leaflabs/lotus-cmvbreakout/Documents/cmv12000_breakout.pdf

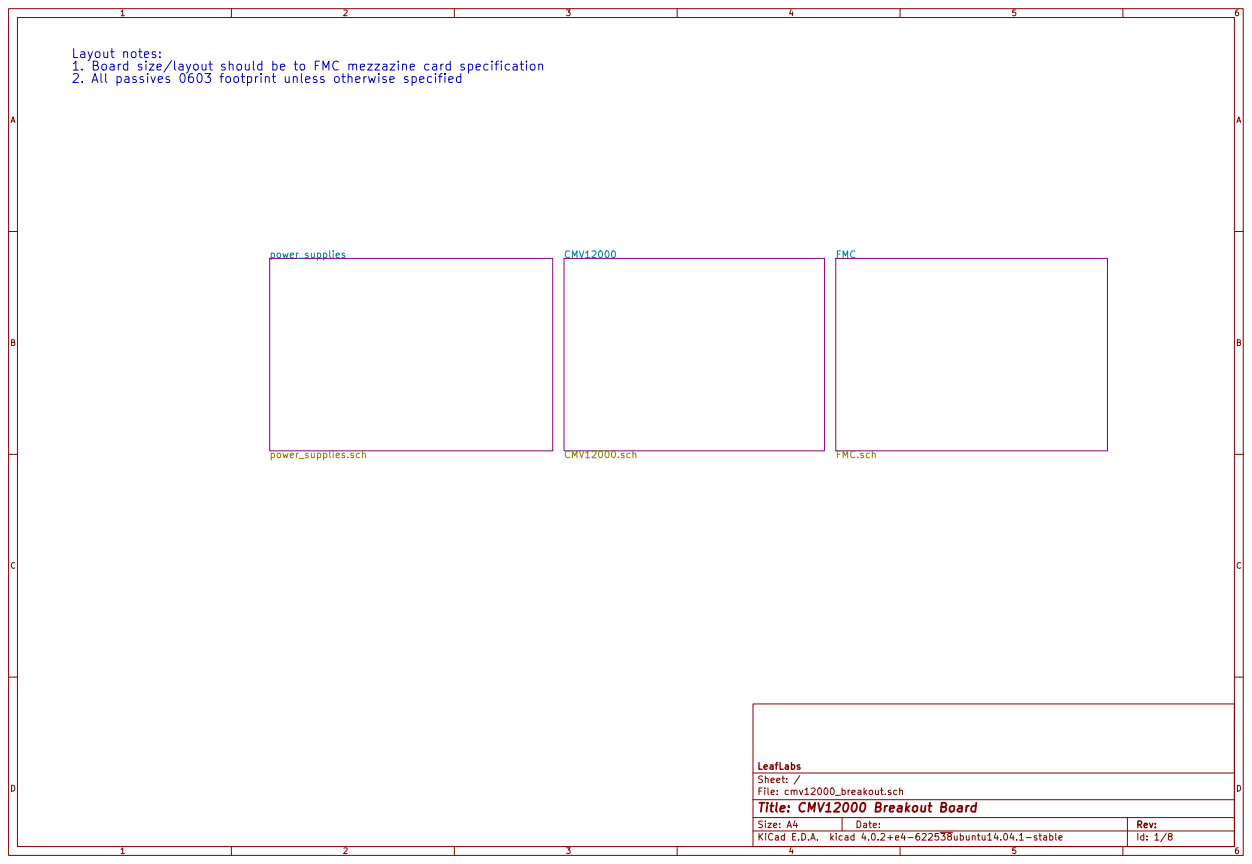
[picture p1: page 1]

Layout notes:
1. Board size/layout should be to FMC mezzazine card specification
2. All passives 0603 footprint unless otherwise specified

File: cmv12000_breakout.sch Sheet: / LeafLabs

Id: 1/8 Title: CMV12000 Breakout Board

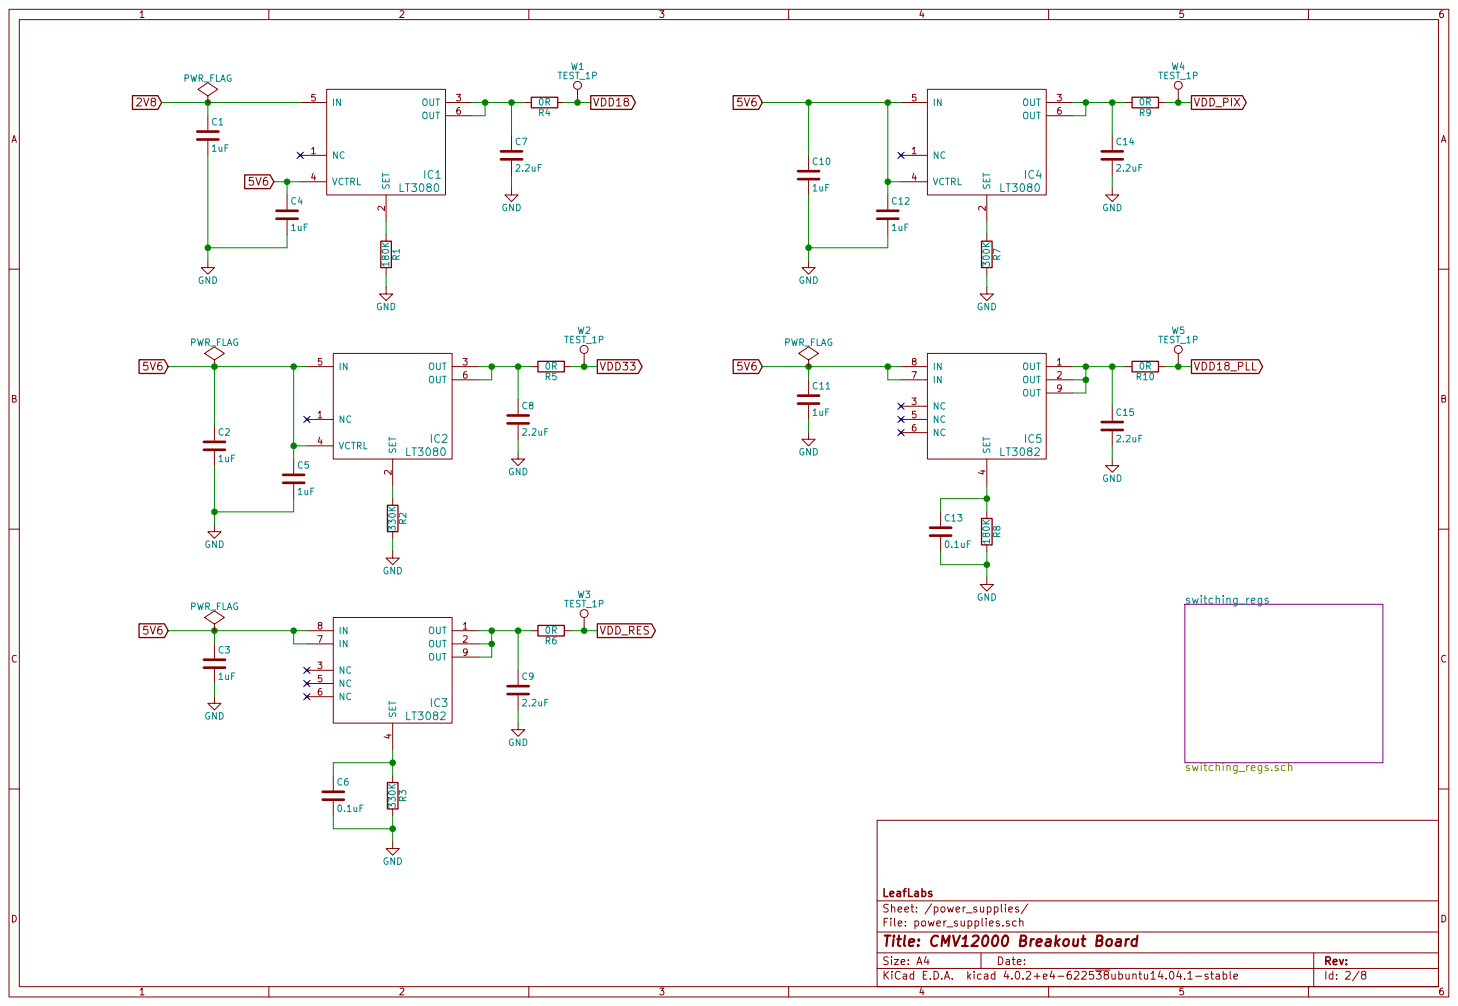
[picture p2: page 2]

File: power_supplies.sch
Id: 2/8 Title: CMV12000 Breakout Board

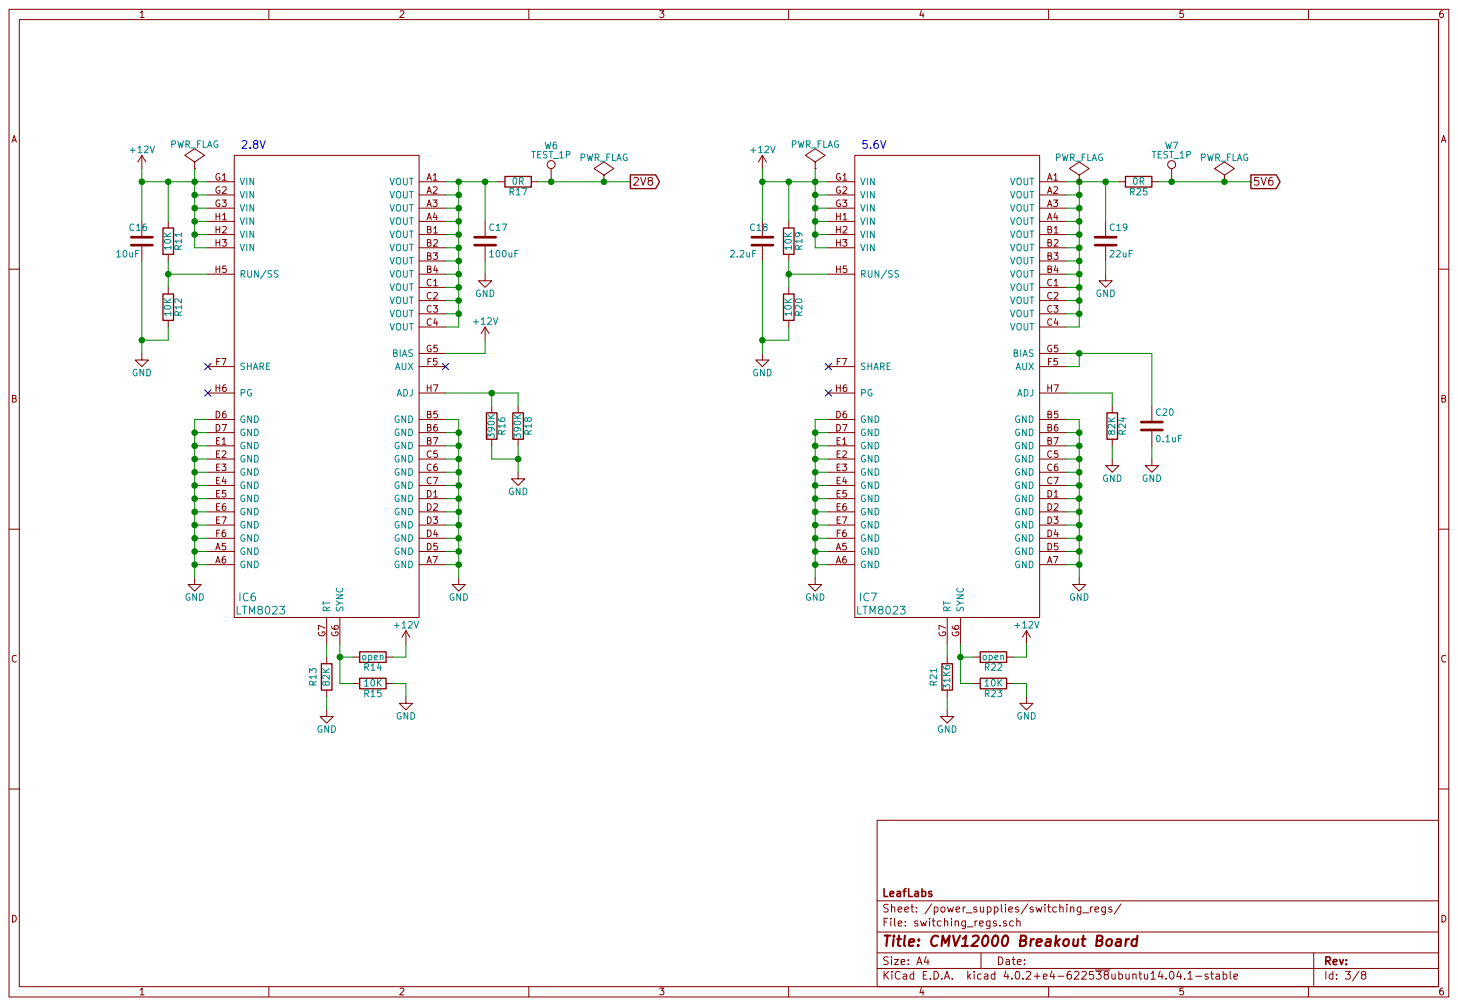
[picture p3: page 3]

File: switching_regs.sch
Id: 3/8 Title: CMV12000 Breakout Board

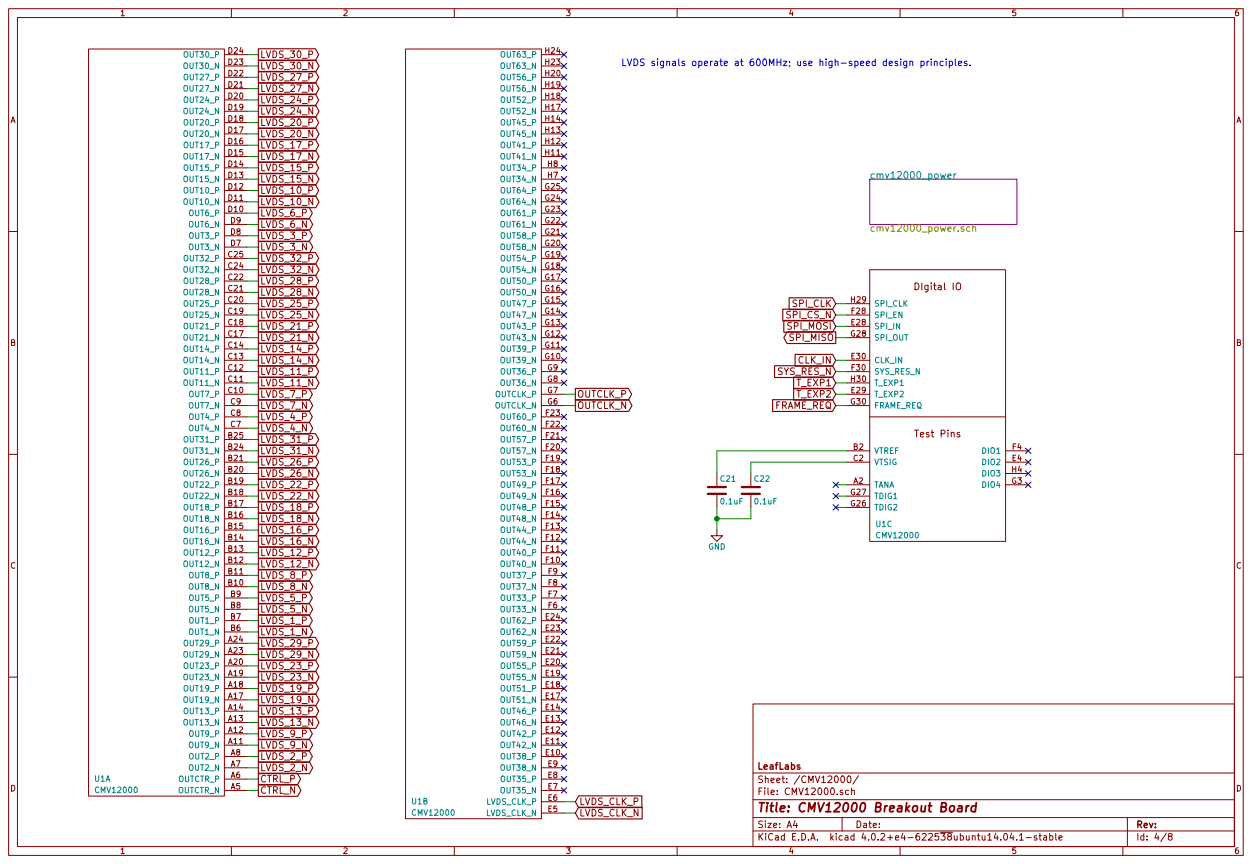
[picture p4: page 4]

LVDS signals operate at 600MHz; use high-speed design principles.

File: CMV12000.sch Sheet: /CMV12000/ LeafLabs

Id: 4/8 Title: CMV12000 Breakout Board

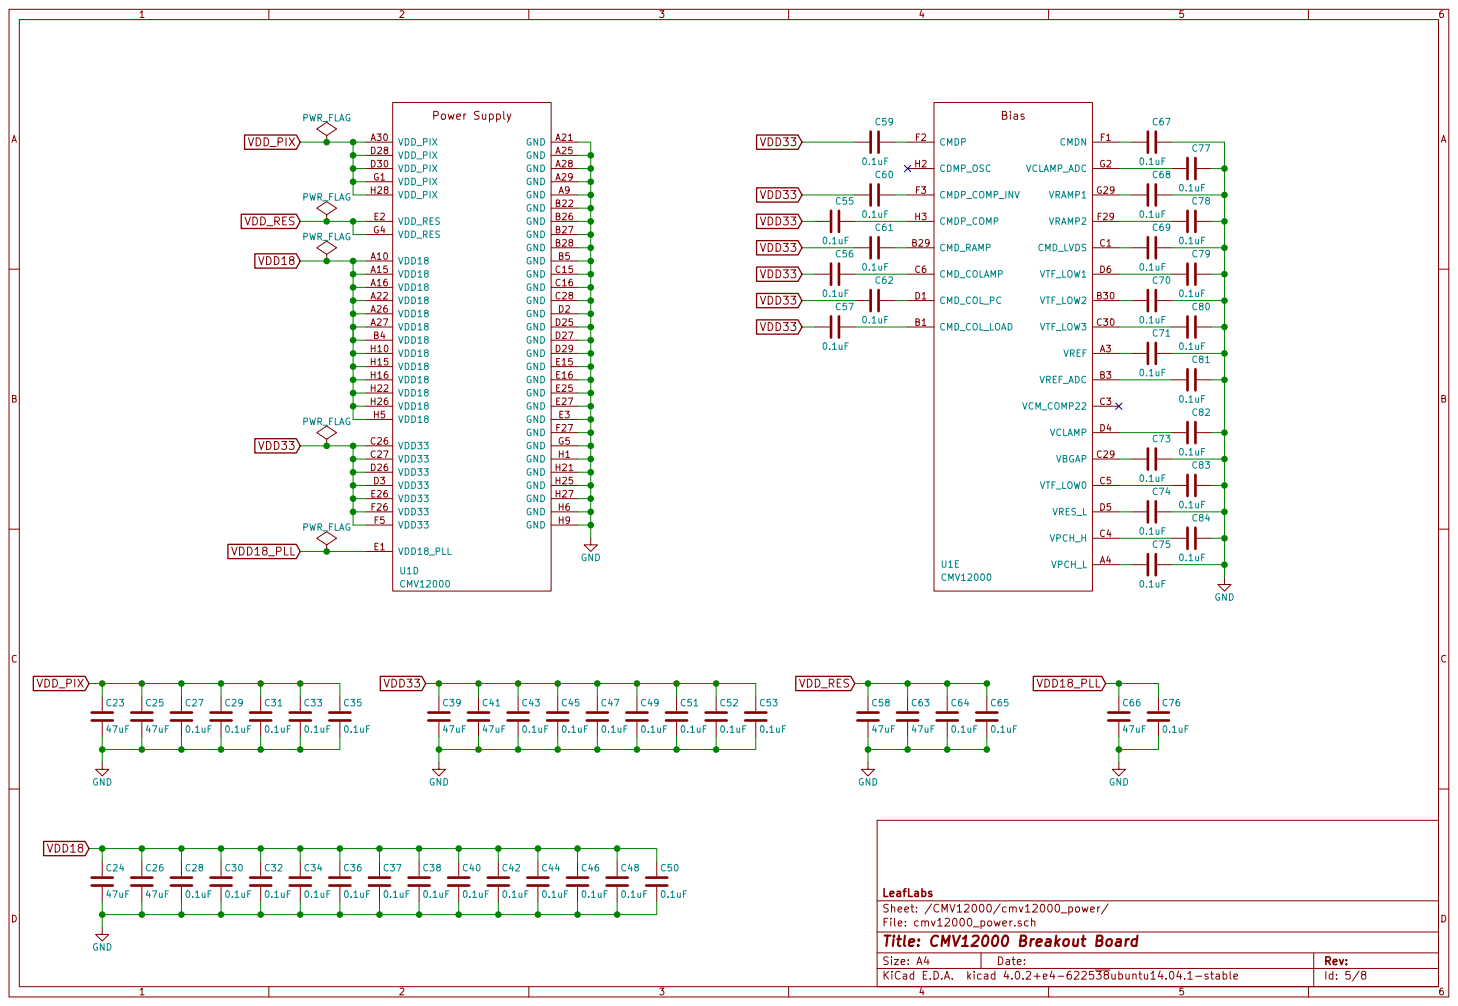
[picture p5: page 5]

File: cmv12000_power.sch
Id: 5/8 Title: CMV12000 Breakout Board

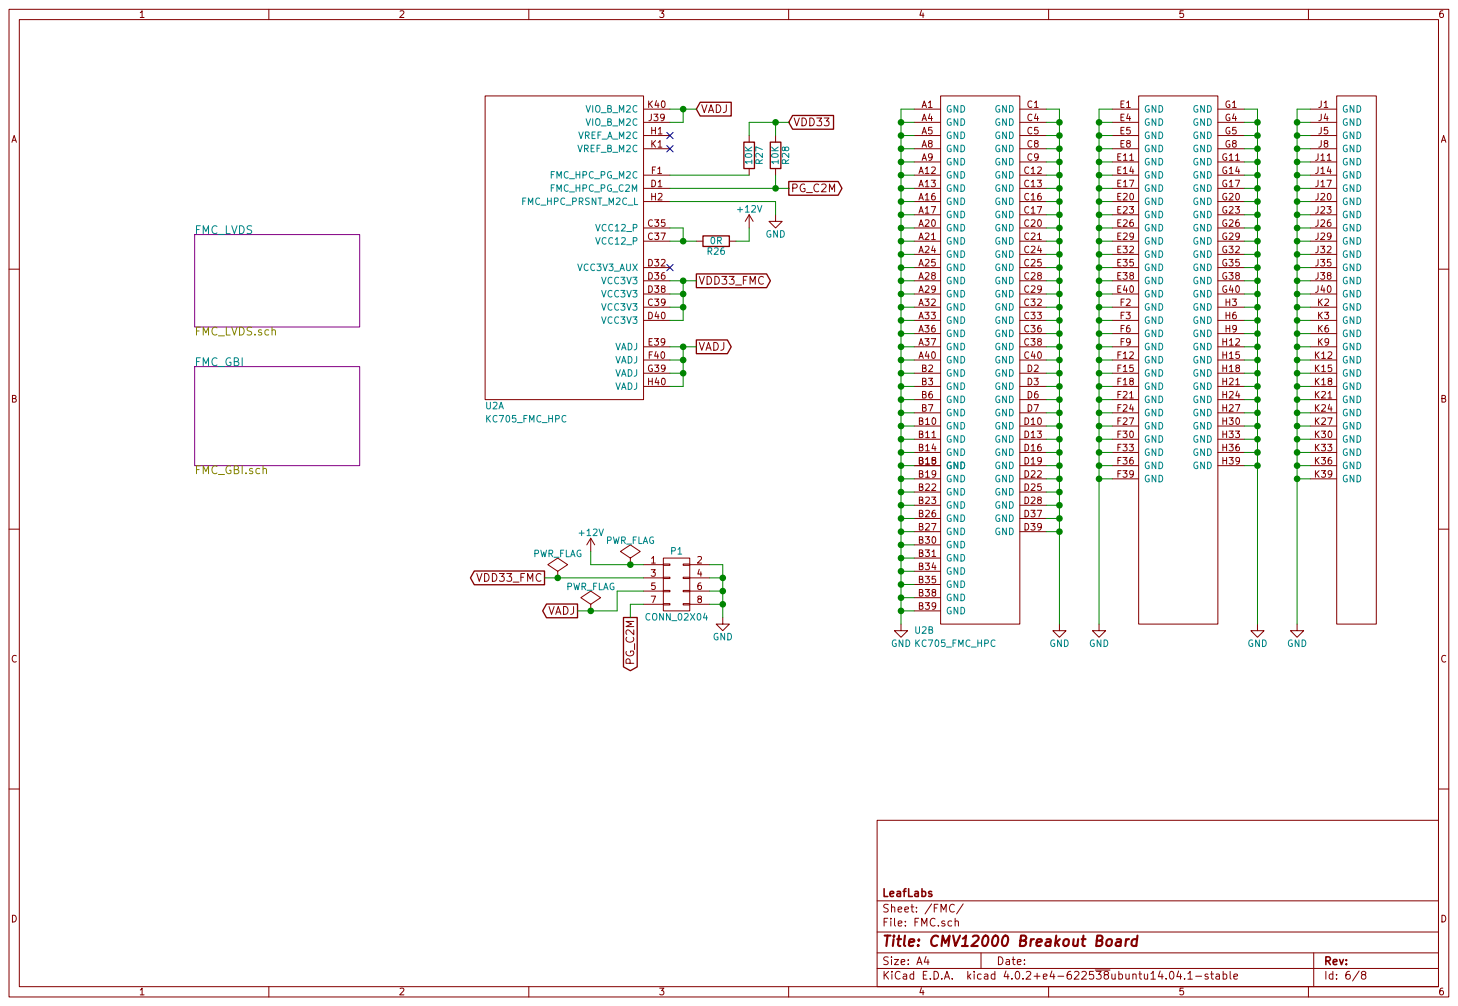
[picture p6: page 6]

File: FMC.sch Sheet: /FMC/ LeafLabs

Id: 6/8 Title: CMV12000 Breakout Board

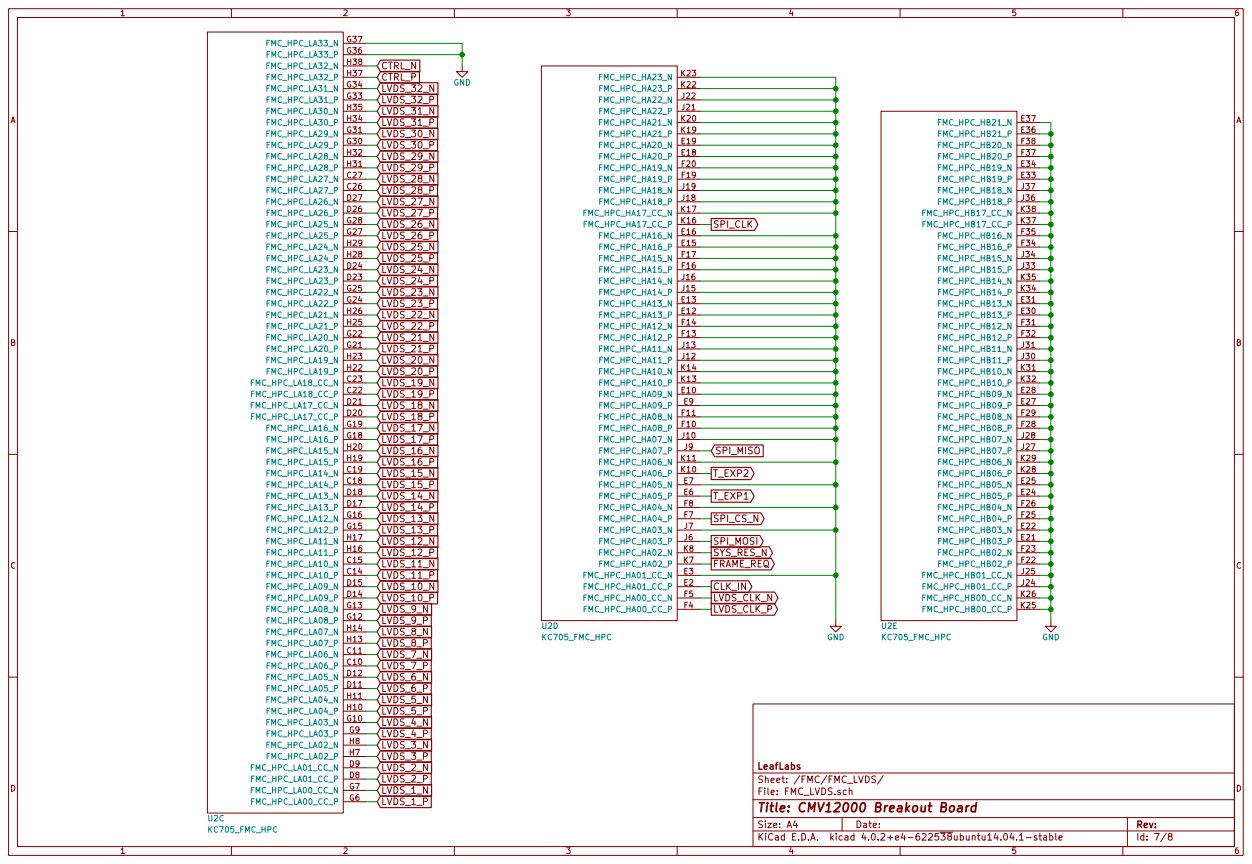
[picture p7: page 7]

SPI_CS_N

SYS_RES_N

File: FMC_LVDS.sch
Id: 7/8 Title: CMV12000 Breakout Board

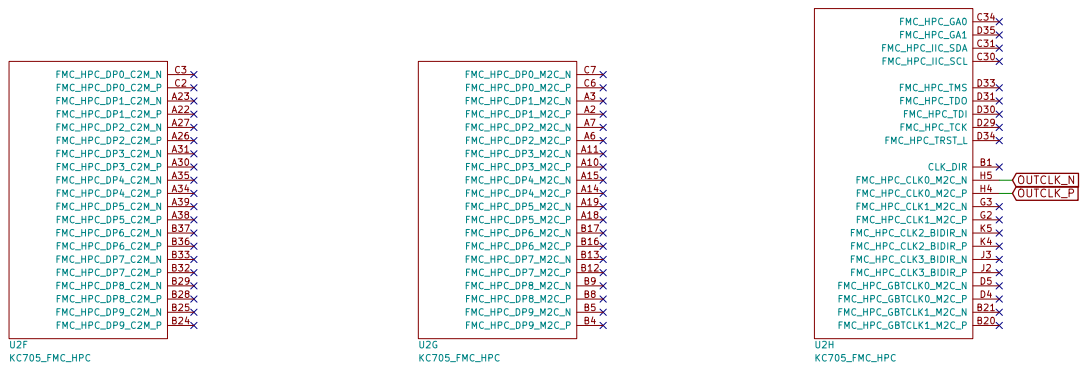
[picture p8: page 8]

File: FMC_GBI.sch
Id: 8/8 Title: CMV12000 Breakout Board
