leaflabs/lotus-cmvbreakout/(commit log)

2016-07-18 Initial commit.
    CMV12000 power banks; other empty schematic sheets.
    [CMV12000.sch, FMC.sch, cmv12000_breakout.kicad_pcb, cmv12000_breakout.sch, cmv12000_power.sch, power_supplies.sch]
2016-07-19 Fixed bypass cap value in CMV12000 power bank schematic.
    [cmv12000_power.sch]
2016-07-19 Added DAC Set Supplies schematic.
    [DAC_set_supplies.sch, power_supplies.sch]
2016-07-19 Added Supply Monitor schematic.
    [power_supplies.sch, supply_monitor.sch]
2016-07-19 Added schematic for 5.6V and 2.8V switching regulators.
    [power_supplies.sch, switching_regs.sch]
2016-07-21 Added subsheets to switching regs.
    [switching_regs.sch]
2016-07-21 Added Supply LP schematic.
    [supply_LP.sch]
2016-07-21 Added Supply MP schematic.
    [supply_MP.sch]
2016-07-21 Added Supply HP (VDD18) schematic.
    [supply_VDD18.sch]
2016-07-22 Various power supplies partially hooked up at top level.
    To control/monitor lines etc.
    [power_supplies.sch]
2016-07-24 Added partial set of LVDS lines to FMC schematic.
    [FMC.sch]
2016-07-24 Rearranged FMC schematics; added another subset of pins.
    [FMC_1.sch, FMC_2.sch]
2016-07-24 Added LVDS signals to CMV12000 page.
    [CMV12000.sch]
2016-07-24 Added control signals to CMV12000 page.
    [CMV12000.sch]
2016-07-24 More top level power supplies hookups.
    [power_supplies.sch]
2016-07-24 Cosmetic/naming changes.
    Automatic sheet renumberings, moving some components around, etc.
    [CMV12000.sch, DAC_set_supplies.sch, FMC.sch, FMC_1.sch, FMC_2.sch, cmv12000_breakout.sch, cmv12000_power.sch, supply_LP.sch]
2016-07-24 Added title/company name.
    [CMV12000.sch, DAC_set_supplies.sch, FMC.sch, FMC_1.sch, FMC_2.sch, cmv12000_breakout.sch, cmv12000_power.sch, power_supplies.sch]
2016-07-25 Added ground bank to FMC schematic.
    [FMC.sch, FMC_1.sch, FMC_2.sch]
2016-07-27 Checkpoint before reworking FMC HPC component.
    [CMV12000.sch, DAC_set_supplies.sch, FMC.sch, FMC_1.sch, FMC_2.sch, cmv12000_breakout.sch, cmv12000_power.sch, power_supplies.sch]
2016-07-27 Rearranging FMC schematic pages.
    [FMC.sch, FMC_LVDS.sch]
2016-07-27 Rearranging/renaming FMC files.
    [FMC_1.sch, FMC_2.sch, FMC_GBI.sch]
2016-07-27 Added relevant FMC units to gigabit interface schematic.
    [FMC_GBI.sch]
2016-07-28 Testpin fixup on CMV12000.
    [CMV12000.sch]
2016-07-30 Simplified power supply circuitry; removed extraneous files.
    Pulled out monitor ADC and supply set DAC; all power supplies are
    now just hard-wired to their various voltage levels.
    [CMV12000.sch, DAC_set_supplies.sch, FMC.sch, FMC_GBI.sch, FMC_LVDS.sch, cmv12000_breakout.sch, cmv12000_power.sch, power_supplies.sch]
2016-08-01 Added power connections to FMC schematic page.
    [FMC.sch]
2016-08-01 Added 0R resistors/test points to power circuitry.
    [power_supplies.sch, switching_regs.sch]
2016-08-01 Annotated components.
    [CMV12000.sch, FMC.sch, FMC_GBI.sch, FMC_LVDS.sch, cmv12000_breakout.sch, cmv12000_power.sch, power_supplies.sch, switching_regs.sch]
2016-08-01 Added no-connects on unused FMC lines.
    [FMC_GBI.sch]
2016-08-01 Minor modifications/bug chasing to pass ERC.
    [CMV12000.sch, FMC.sch, FMC_LVDS.sch, cmv12000_power.sch, power_supplies.sch, switching_regs.sch]
2016-08-01 ERC error cleanup on switching regs and power supplies pages.
    [power_supplies.sch, switching_regs.sch]
2016-08-01 Fixed LVDS pin directionality.
    [CMV12000.sch, FMC.sch, FMC_GBI.sch, FMC_LVDS.sch, cmv12000_breakout.sch, cmv12000_power.sch, power_supplies.sch, switching_regs.sch]
2016-08-02 Annotations; removing unused signals; general cleanup.
    [CMV12000.sch, FMC.sch, FMC_GBI.sch, FMC_LVDS.sch, cmv12000_power.sch, power_supplies.sch, switching_regs.sch]
2016-08-04 added some footprint annotations to power supplies sheet
    [power_supplies.sch]
2016-08-05 started defining footprints and making nonstandard footprints
    [CMV12000.sch, FMC.sch, FMC_GBI.sch, FMC_LVDS.sch, cmv12000_breakout.sch, cmv12000_power.sch, power_supplies.sch, switching_regs.sch]
2016-08-07 simplifying switching regulators
    [CMV12000.sch, FMC.sch, FMC_GBI.sch, FMC_LVDS.sch, cmv12000_breakout.sch, cmv12000_power.sch, power_supplies.sch, switching_regs.sch]
2016-08-08 finished defining footprints
    [CMV12000.sch, FMC.sch, FMC_LVDS.sch, cmv12000_power.sch, power_supplies.sch, switching_regs.sch]
2016-09-06 resolved more footprints and added finishing touches/gerbers
    [CMV12000.sch, FMC.sch, FMC_GBI.sch, FMC_LVDS.sch, cmv12000_breakout.sch, cmv12000_breakout_bom.csv, cmv12000_power.sch, power_supplies.sch]
2016-11-01 moving changes from local machine to repositories
    [CMV12000.sch, FMC.sch, FMC_GBI.sch, FMC_LVDS.sch, cmv12000_power.sch]
2016-11-01 connected FMC (u2) pin D30 to FMC (u2) pin D31
    [CMV12000.sch, FMC.sch, FMC_GBI.sch, FMC_LVDS.sch, cmv12000_breakout.sch, cmv12000_power.sch, power_supplies.sch, switching_regs.sch]
2016-11-01 added 100 ohm termination to sensor differential input clock, also bypass caps
    [FMC_GBI.sch, FMC_LVDS.sch]
2016-11-02 added test points for ground to switching supplies
    [CMV12000.sch, FMC.sch, FMC_GBI.sch, FMC_LVDS.sch, cmv12000_breakout.sch, cmv12000_power.sch, power_supplies.sch, switching_regs.sch]
2016-11-02 updated 1V8 supply to correct part (LT3083) with proper passive values, and assigned proper footprint
    [power_supplies.sch]
2016-11-02 removed VDD18_PLL supply and associated decoupling caps from design
    [CMV12000.sch, FMC.sch, FMC_GBI.sch, FMC_LVDS.sch, cmv12000_power.sch, power_supplies.sch, switching_regs.sch]
2016-11-02 updated vdd33 supply to correct footprint and passive topology
    [power_supplies.sch]
2016-11-02 updated vdd_pix supply, footprint, and passive topology
    [power_supplies.sch]
2016-11-02 fixed lt3082 supply, changed test points for linear regulators
    [CMV12000.sch, FMC.sch, FMC_LVDS.sch, cmv12000_power.sch, power_supplies.sch, switching_regs.sch]
2016-11-03 finished adding test points, added detachable test points to clock signals, added power enable control to FPGA, fixed termination placement
    [CMV12000.sch, FMC.sch, FMC_LVDS.sch, cmv12000_power.sch, switching_regs.sch]
2016-11-03 fixed component annotations
    [CMV12000.sch]
2016-11-03 fixed supply output voltages
    [power_supplies.sch]
2016-11-04 grounded VTF_LOW0-1, grounded FMC pins C34 D35, added 47uF cap to VDD18 bank
    [CMV12000.sch, FMC.sch, FMC_GBI.sch, cmv12000_power.sch, power_supplies.sch, switching_regs.sch]
2016-11-04 fixed 100 ohm termination footprint
    [CMV12000.sch, FMC.sch, FMC_GBI.sch, FMC_LVDS.sch, cmv12000_power.sch, power_supplies.sch, switching_regs.sch]
